Nicolai-Electronics/i2c-parallel-port/parallel_port.kicad_pcb

## KiCad design parallel_port.kicad_pcb (2024-01-03)

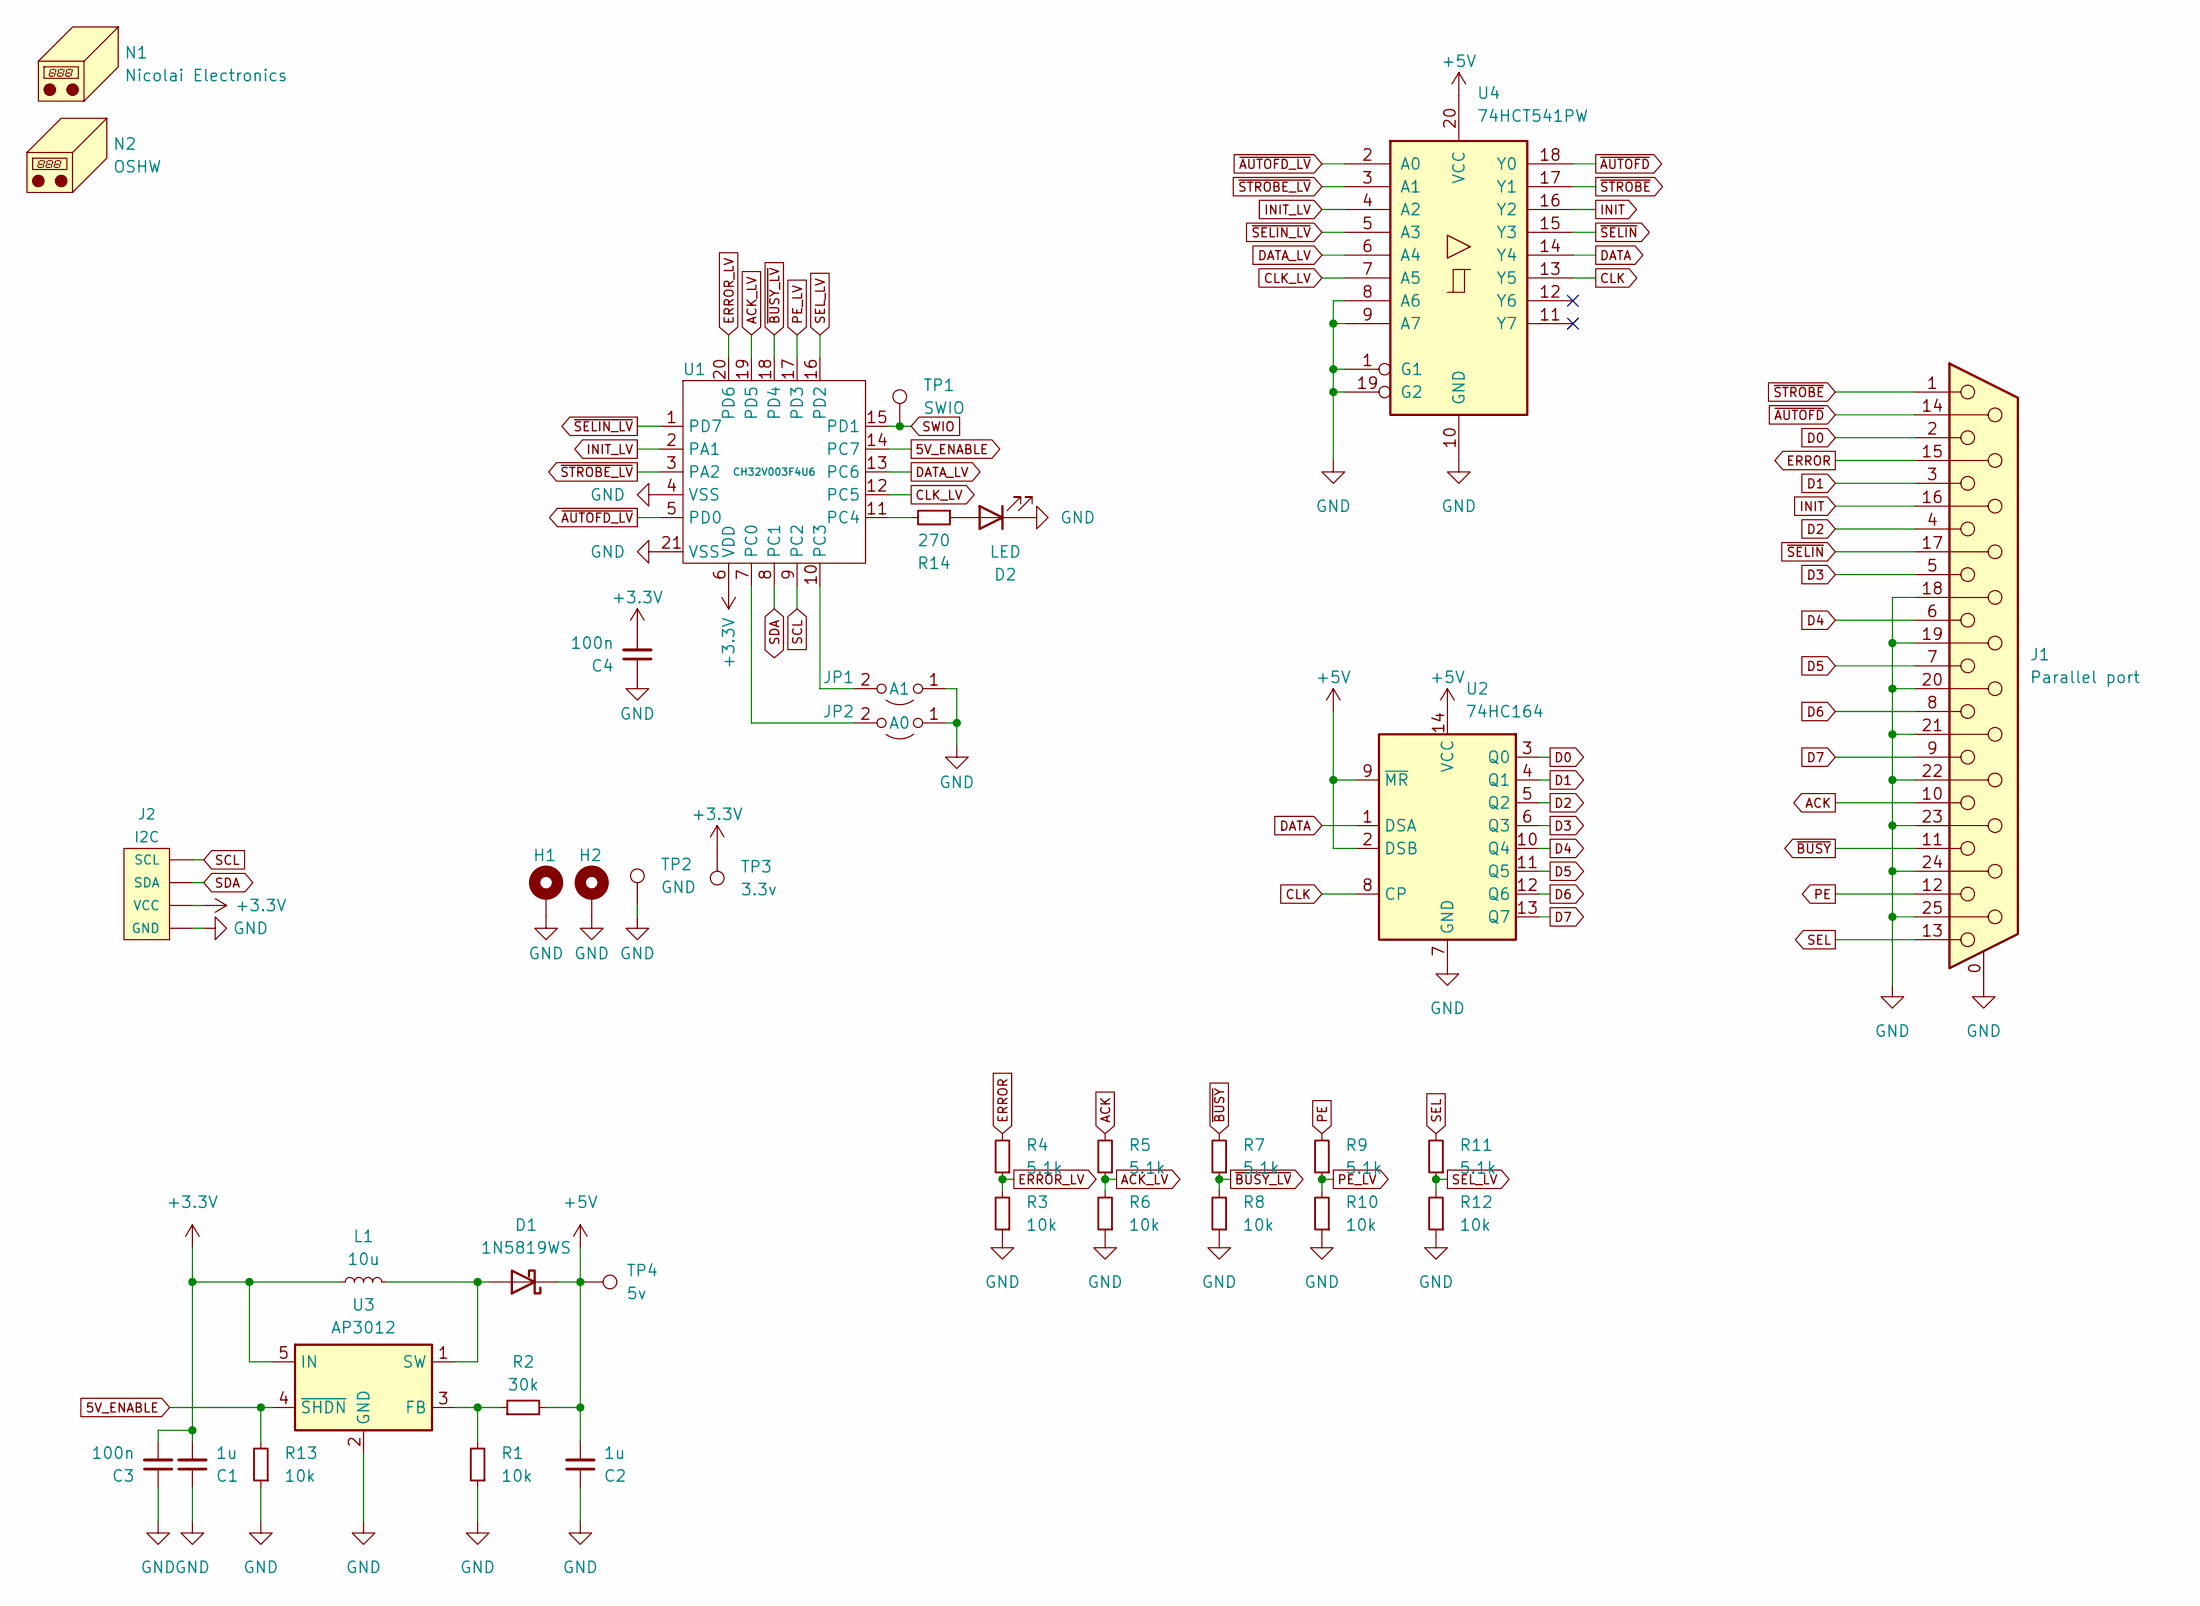
[picture p1: schematic parallel_port.kicad_sch, I2C to parallel port]

Parts:
C1, C2: 1u; C_0402_1005Metric
C3, C4: 100n; C_0402_1005Metric
D1: 1N5819WS; D_SOD-323
D2: LED; LED_0603_1608Metric; LCSC C264473
H1, H2: MountingHole_3.2mm_M3_Pad_Via
J1: Parallel port; DSUB-25_Female_Horizontal_P2.77x2.84mm_EdgePinOffset7.70mm_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
J2: I2C; 1X04_1MM_RA_GND; LCSC C160404
JP1: A1; SolderJumper-2_P1.3mm_Open_TrianglePad1.0x1.5mm
JP2: A0; SolderJumper-2_P1.3mm_Open_TrianglePad1.0x1.5mm
L1: 10u; Inductor_MSC20FC; Part Ceaiya CRH201610S-100MT; LCSC C520204
N1: Nicolai Electronics; logo_nicolai
N2: OSHW; OSHW-Logo2_7.3x6mm_Mask
R1, R3, R6, R8, R10, R12, R13: 10k; R_0402_1005Metric
R2: 30k; R_0402_1005Metric
R4, R5, R7, R9, R11: 5.1k; R_0402_1005Metric
R14: 270; R_0402_1005Metric; LCSC C22966
TP1: SWIO; TestPoint_Pad_D2.0mm
TP2: GND; TestPoint_Pad_D2.0mm
TP3: 3.3v; TestPoint_Pad_D2.0mm
TP4: 5v; TestPoint_Pad_D2.0mm
U1: CH32V003F4U6; QFN-20-1EP_3x3mm_P0.4mm_EP1.65x1.65mm; LCSC C5299908
U2: 74HC164; SO-14_3.9x8.65mm_P1.27mm; LCSC C6825
U3: AP3012; SOT-23-5; LCSC C102618
U4: 74HCT541PW; TSSOP-20_4.4x6.5mm_P0.65mm; LCSC C131314

Connections:
5V_ENABLE: R13.2, U1.14 (PC7), U3.4 (~SHDN)
+3.3V: C1.2, C3.2, C4.2, J2.2 (VCC), L1.1, TP3.1, U1.6 (VDD), U3.5 (IN)
+5V: C2.2, D1.1 (K), R2.2, TP4.1, U2.2 (DSB), U2.9 (~MR), U2.14 (VCC), U4.20 (VCC)
ACK: J1.10, R5.2
ACK_LV: R5.1, R6.2, U1.19 (PD5)
CLK: U2.8 (CP), U4.13 (Y5)
CLK_LV: U1.12 (PC5), U4.7 (A5)
D0: J1.2, U2.3 (Q0)
D1: J1.3, U2.4 (Q1)
D2: J1.4, U2.5 (Q2)
D3: J1.5, U2.6 (Q3)
D4: J1.6, U2.10 (Q4)
D5: J1.7, U2.11 (Q5)
D6: J1.8, U2.12 (Q6)
D7: J1.9, U2.13 (Q7)
DATA: U2.1 (DSA), U4.14 (Y4)
DATA_LV: U1.13 (PC6), U4.6 (A4)
ERROR: J1.15, R4.2
ERROR_LV: R3.2, R4.1, U1.20 (PD6)
GND: C1.1, C2.1, C3.1, C4.1, D2.1 (K), H1.1, H2.1, J1.0 (PAD), J1.18, J1.19, J1.20, J1.21, J1.22, J1.23, J1.24, J1.25, J2.1 (GND), J2.5, J2.6, JP1.1 (A), JP2.1 (A), R1.1, R3.1, R6.1, R8.1, R10.1, R12.1, R13.1, TP2.1, U1.4 (VSS), U1.21 (VSS), U2.7 (GND), U3.2 (GND), U4.1 (G1), U4.8 (A6), U4.9 (A7), U4.10 (GND), U4.19 (G2)
INIT: J1.16, U4.16 (Y2)
INIT_LV: U1.2 (PA1), U4.4 (A2)
unnamed: D1.2 (A), L1.2, U3.1 (SW)
unnamed: D2.2 (A), R14.1
unnamed: JP1.2 (B), U1.10 (PC3)
unnamed: JP2.2 (B), U1.7 (PC0)
unnamed: R14.2, U1.11 (PC4)
unnamed: R1.2, R2.1, U3.3 (FB)
PE: J1.12, R9.2
PE_LV: R9.1, R10.2, U1.17 (PD3)
SCL: J2.4 (SCL), U1.9 (PC2)
SDA: J2.3 (SDA), U1.8 (PC1)
SEL: J1.13, R11.2
SEL_LV: R11.1, R12.2, U1.16 (PD2)
SWIO: TP1.1, U1.15 (PD1)
~AUTOFD_LV: U1.5 (PD0), U4.2 (A0)
~AUTOFD: J1.14, U4.18 (Y0)
~BUSY_LV: R7.1, R8.2, U1.18 (PD4)
~BUSY: J1.11, R7.2
~SELIN_LV: U1.1 (PD7), U4.5 (A3)
~SELIN: J1.17, U4.15 (Y3)
~STROBE_LV: U1.3 (PA2), U4.3 (A1)
~STROBE: J1.1, U4.17 (Y1)

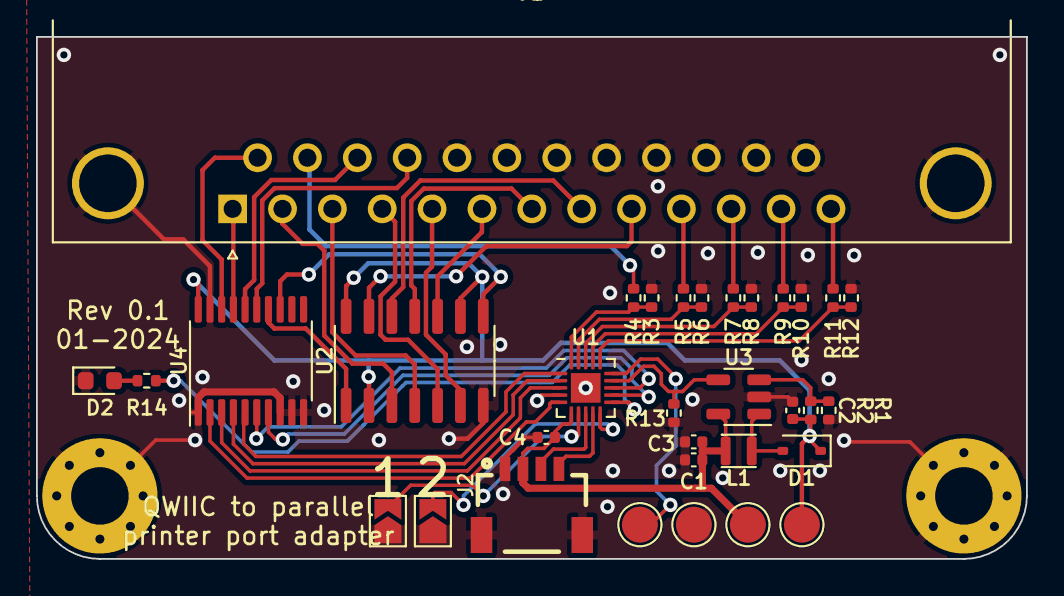
[picture p2: board parallel_port.kicad_pcb from above]

Board: 2 copper layers, 55.0 x 29.0 mm, 37 parts (1 on the bottom side), 43 nets.
